runeseghers/OXYBLOOM/README.md

# Oxybloom
Een slimme bloem die huishoudens helpt om de luchtkwaliteit te verbeteren.

🛠️ Built by ``Dré Devaere`` & ``Rune Seghers``   
🔥 Supervised by ``prof. dr. Bas Baccarne``, ``Yannick Christiaens`` & ``Wouter Devriese``    
🌱 Grown at ``Ghent University`` 🏛️ ``Industrial Design Engineering`` ([project overview](https://github.com/basbaccarne/human-centered-design))       

13/06/2026  

## Samenvatting
Veel mensen ventileren hun huis niet op de juiste manier, of doen dit te weinig, vaak uit onwetendheid. Dit kan leiden tot een onnodig energieverbruik, slechtere luchtkwaliteit en vochtproblemen. Om inzicht te krijgen in dit probleem werd een enquête afgenomen bij ongeveer 100 respondenten. Daaruit bleek dat 50% van de deelnemers zich niet bewust is van het verband tussen duurzaamheid en correcte ventilatie. Dit wijst duidelijk op een kennis- en gedragskloof: veel mensen weten niet wanneer en hoe ze hun woning optimaal kunnen ventileren.

De oplossing is OXYBloom: een slimme bloem die gebruikers op een laagdrempelige en visueel aantrekkelijke manier begeleidt bij het ventileren op de juiste momenten en op de juiste manier. Het product meet voortdurend de luchtkwaliteit (CO₂ en vocht) en geeft hierover feedback via kleurveranderingen, een subtiele beweging van de bladeren en voice feedback. Via de bijhorende app krijgen gebruikers extra inzicht, bijvoorbeeld in hun energiebesparing, en kunnen ze het product personaliseren (kleuren, beloningssysteem). Een geïntegreerde luchtbevochtiger met waterreservoir zorgt bovendien voor een aangenamere luchtvochtigheid en versterkt de gebruikerservaring, doordat het bijvullen aanvoelt als het verzorgen van een echte plant.

Door dit hulpmiddel te gebruiken kunnen bewoners efficiënter ventileren, waardoor ze minder energie verbruiken om bijvoorbeeld te verwarmen. Daarnaast draagt correcte ventilatie bij aan een gezonder binnenklimaat: vochtproblemen en schimmelvorming worden beperkt, en de lucht in huis blijft frisser.

Op deze manier helpt onze oplossing niet alleen het energieverbruik te verminderen, maar verbetert het ook het wooncomfort en de gezondheid van de bewoners. Door bewust ventilatiegedrag te stimuleren op een manier die intuïtief, esthetisch en stand-alone werkt, sluiten we de kennis- en gedragskloof en zorgen we voor een duurzamere en gezondere leefomgeving.

<p align="center">
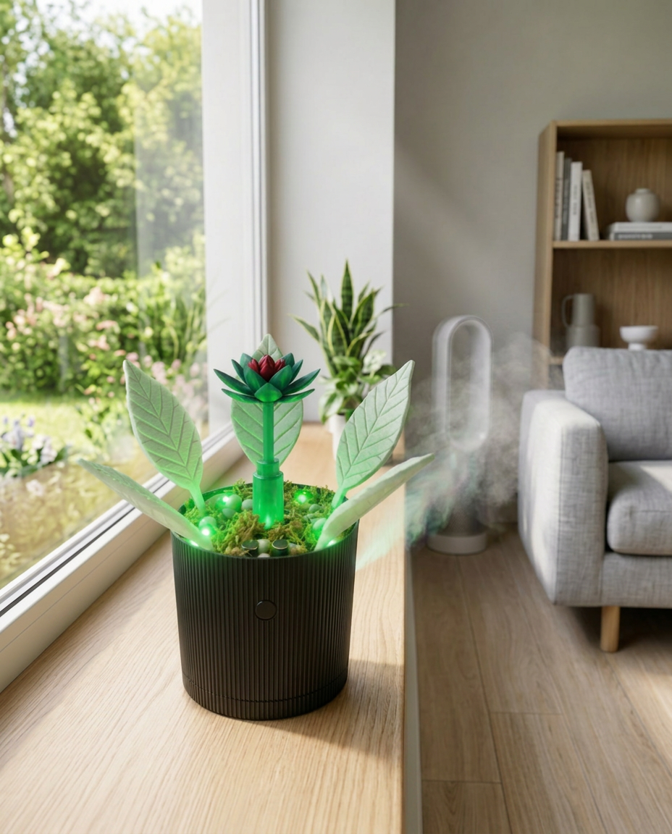
[picture p1: img/finale heroshot.png]
  
</p>

## Introductie
Veel mensen ventileren hun huis niet correct of doen dit te weinig, vaak uit onwetendheid. Dit kan leiden tot een slechtere luchtkwaliteit, vochtproblemen en onnodig energieverbruik, vooral in goed geïsoleerde woningen. Uit een [enquête](https://docs.google.com/document/d/1lkF2mxv8E-GvEGbEEImv3dyBfMGQf3W1utyAzGHfSRQ/edit?tab=t.0) onder ongeveer 100 respondenten bleek dat 50% van de deelnemers zich niet bewust is van het verband tussen duurzaamheid en correcte ventilatie. Dit laat zien dat er een duidelijke kennis- en gedragskloof bestaat: veel bewoners weten niet wanneer en hoe ze hun woning optimaal kunnen ventileren.

Het doel van dit project is een product te ontwerpen dat bewoners actief ondersteunt bij ventileren. Het apparaat meet continu het binnenklimaat, zoals luchtvochtigheid en CO₂-niveau. Op basis hiervan geeft het product signalen wanneer de luchtkwaliteit binnen niet goed is en het dus het beste moment is om te verluchten.

Doorheen het proces is dit basisconcept verder uitgewerkt tot Oxybloom: een bloemvormig product dat de status van de luchtkwaliteit communiceert via kleurveranderingen, een rustige, ademende beweging van de bladeren en voice feedback. Gebruikers bedienen het product via geïntegreerde knoppen op de pot zelf, en kunnen via een bijhorende [app](https://last-name-51594304.figma.site) dieper inzicht krijgen (zoals energiebesparing, een streak-systeem en het personaliseren van kleuren), zonder dat deze app verplicht is voor de basiswerking. Daarnaast werd een luchtbevochtiger met waterreservoir toegevoegd, die zowel de luchtvochtigheid verbetert als de interactie met het product aangenamer maakt. Ook de vorm, materialen en afwerking (CMF) van de bloem werden via meerdere gebruikerstests verfijnd, zodat het product esthetisch aansluit bij verschillende interieurs en als een natuurlijk, herkenbaar object in een woonruimte past.

Het product werkt energiebesparend en draagt bij aan een gezonder binnenklimaat. Door efficiënter te ventileren, hoeft minder energie te worden gebruikt om de woning te verwarmen of te koelen. Bovendien helpt het vochtproblemen en schimmelvorming te voorkomen, waardoor de luchtkwaliteit verbetert en de woning comfortabeler en gezonder wordt.

## Inhoudstafel

1. [Methodologie](./docs/methodologie.md)
2. [Discovery](./docs/discovery.md)
3. [Defintion](./docs/definition.md)
4. [Develop 1](./docs/develop_1.md)
5. [Develop 2](./docs/develop_2.md)
6. [Develop 3](./docs/develop_3.md)
7. [Design Requirements](./docs/design_requirements.md)
8. [Bill of materials](./docs/bom.md)
9. [Conclusie](./docs/conclusie.md)

## Kritische reflectie

Voor de eerste develop-fase hebben we, met behulp van een vernieuwd prototype, het project naar een hoger niveau kunnen tillen: gebruikers konden zich beter voorstellen hoe het product werkt, wat tot waardevolle inzichten leidde. Door tijdens de tests dieper door te vragen naar het "waarom" achter reacties, en door de Wizard of Oz-methode toe te passen, konden we observeren hoe voice feedback werd ontvangen en hierop bijsturen.

Achteraf bleek onze aanpak hier te weinig genuanceerd: we gingen uit van één type feedback voor alle situaties. Ook was het zo dat het beter zou zijn om te testen per parameter en niet enkele parameters in één keer.

Tijdens de tweede develop-fase hebben we een belangrijke les uit develop 1 in de praktijk gebracht: het belang van testen in de juiste context. Waar we in develop 1 onvoldoende rekening hielden met de omgeving waarin het product effectief gebruikt zou worden, hebben we dit in develop 2 wel meegenomen door de antropometrische tests en de gebruikerstests af te stemmen op realistische scenario's, zoals tafelhoogte en kasthoogte. Hierdoor verkregen we relevantere en bruikbaardere resultaten, die rechtstreeks bijdroegen aan de positionering van de knoppen en de algemene ergonomie van het product.

In de derde develop-fase lag de focus op het waterreservoir en de CMF-keuzes (Color, Material, Finish). Hoewel deze fase waardevolle inzichten heeft opgeleverd, merken we achteraf dat we hierbij iets te veel tijd hebben gespendeerd aan het verfijnen van het prototype, ten koste van de algemene voortgang. We willen voortdurend vooruitgang boeken in onze prototypes, maar moeten hierbij beter bewaken dat dit binnen een redelijke tijdspanne gebeurt, zodat de balans tussen kwaliteit en efficiëntie behouden blijft. Idealiter zouden de CMF-testen afgenomen worden bij personen wiens interieur aansluit bij de geteste bloempotstijl. Door de beperkte tijd was dit niet mogelijk, waardoor we testten bij personen met uiteenlopende interieurs. Dit maakte het moeilijker om een duidelijke lijn in de voorkeuren te vinden, maar leverde wel verschillende waardevolle perspectieven op.

## Noot inzake het gebruik van AI
AI werd gebruikt om inspiratie te verkrijgen over bestaande apparaten, zodat deze konden worden gebenchmarkt. Ook werd het gebruikt om een storyboard te maken na dat de verschillende situaties werden uitgeschreven. Het hero shot is ook deels gemaakt met AI. Verder werd AI ook gebruikt een interface te maken voor een toekomstige app via Figma Make om zo wat tijd te besparen.

Bij develop 3 is er gebruikt gemaakt van vizcom. Vizcom is een site waarop je foto's kan laten bewerken door AI. Dit werkt gebruikt om verschillende design keuzes te laten genereren door middel van kernwoorden.

Bij conclusie de kostprijscalculatie is gedaan aan de han van ai.

## Bijlagen
### Discovery
* Literatuuronderzoek (N=11)
  * [Rapport](https://docs.google.com/document/d/1AfcCo7FvvEoZ-1zk95RXVjzMou38a-mL8L6_zgns-Gg/edit?tab=t.0)
* Interviews (N=3)
  * [Protocol](https://docs.google.com/document/d/12qbczfWnEImfsNoVpZ4aLVHFY0JWGxJDZ43AeHY9-mw/edit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)
  * [Rapport](https://docs.google.com/document/d/1SwhVlLS8_lIYlqKu6CdZsSIWJLKw36k-8GklZlpGox8/edit?usp=sharing)
* Benchmarking (N=10)
  * [Rapport](https://docs.google.com/document/d/12xce8BJE52bgFbQwACKA-BeoK-U8daDStCAenrfK3ME/edit?tab=t.0).
* Enquête (N=104)
  * [Enquête](https://docs.google.com/forms/d/e/1FAIpQLSccWiVOp48grHZ2cQGmuoxTeAmDsEP0Rcj8K9Pg0Ig58J9OUA/viewform)
  * [Rapport](https://docs.google.com/document/d/1lkF2mxv8E-GvEGbEEImv3dyBfMGQf3W1utyAzGHfSRQ/edit?tab=t.0)

### Definition
* User testing wave 1 (N=13)
  * [Protocol](https://docs.google.com/document/d/1rY86oE0Vs1P8iOJ6PyYzX7_pxgFzCAlSUU5zqiSWN3I/edit?tab=t.0)
  * [Rapport](https://docs.google.com/document/d/1wBb8zgVL7p_F-QvWJVQwW2Svkrl49Ys-igBUbI4e8e8/edit?tab=t.0)
* User testing wave 2 (N=5)
  * [Protocol](https://docs.google.com/document/d/1o-T7NU_5Rs0rAPHm1JbzHmHQB5fDIzvxbv1kqwsdvhM/edit?usp=sharing)
  * [Rapport](https://docs.google.com/document/d/1fPvEVBDay3pfUAcs47p9CDcH445wIs4vGXjvJl6ddqQ/edit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)

### Develop 1
* User testing (N=5)
  *  [Protocol](https://docs.google.com/document/d/14uV6BEjJ6iHEM_Fh3N6zzjam72_YUCfdtqbi0Aa-V18/edit?tab=t.0)
  *  [Rapport](https://docs.google.com/document/d/18PjJ0K22VwaZccacPXWkhhGwo1DeL2UdXLAWv1GZMLM/edit?tab=t.0)

### Develop 2
* [Antropometrische Analyse](https://docs.google.com/document/d/1EPGG9i6jSZKGZ7VrqN3QsUSug69F0fZezZaDpOkvLG0/edit?tab=t.0)
* [Enquête Analyse](https://docs.google.com/document/d/19_CdSDRdH0FaFUVYFXiZnsAKY0Y2GnrCZgDpmhAUXtg/edit?tab=t.0)
* [User test protocool](https://docs.google.com/document/d/15RyFqs8qL6PJrg-n36wd5jC9kE5sktj_Zqppsj13D40/edit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)
* [User test analyse](https://docs.google.com/document/d/1LS81rWTh8fn5G55BaOMGvlZr1KS65SzYiV8W_BzbE0Y/edit?tab=t.0)
### Develop 3
* [User test protocool](https://docs.google.com/document/d/1AFxn7SNG4gidYgDGYXC2rl6uFhPbX5SC4VyNPNwO1w4/edit?tab=t.0)
* [User test analyse](https://docs.google.com/document/d/1FLf_whq74Fe5Exia7DLtALLMpERrBxRFpvECkAxbEaY/edit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)

## Licentie

This repository contains both software and design materials created as part of an industrial design energineering project at Ghent University.

- **Software and code:** [MIT License](./LICENSE-MIT)  
- **Design, documentation, CAD, and media:** [CC BY 4.0 License](./LICENSE)
  
You are free to reuse and build upon this work, both commercially and non-commercially, as long as proper attribution is given to the original authors.

## Bronnen
### Benchmarking:
Airthings. (2025). *Wave Plus radon & air quality monitor*. Geraadpleegd op 25 oktober 2025, van https://www.airthings.com/wave-plus
 
Awair. (2025). *Awair Glow air quality monitor*. Geraadpleegd op 25 oktober 2025, van https://www.getawair.com/glow
 
Blueair. (2025). *Blue Pure air purifier series*. Geraadpleegd op 25 oktober 2025, van https://www.blueair.com/nl
 
Eve Systems. (2025). *Eve Room indoor air quality monitor*. Geraadpleegd op 25 oktober 2025, van https://www.evehome.com/nl/eve-room
 
Foobot. (2025). *Foobot air quality monitor*. Geraadpleegd op 25 oktober 2025, van https://www.foobot.com
 
IKEA. (2025). *VINDSTYRKA air quality sensor*. Geraadpleegd op 25 oktober 2025, van https://www.ikea.com/nl/en/p/vindstyrka-air-quality-sensor-30515989/
 
Kaiterra. (2025). *Laser Egg air quality monitor*. Geraadpleegd op 25 oktober 2025, van https://www.kaiterra.com/laseregg
 
Netatmo. (2025). *Healthy Home Coach indoor air quality monitor*. Geraadpleegd op 25 oktober 2025, van https://www.netatmo.com/nl-nl/weather/healthcoach
 
Tado°. (2025). *Smart thermostat and room sensors*. Geraadpleegd op 25 oktober 2025, van https://www.tado.com/nl-nl
 
uHoo. (2025). *uHoo smart air monitor*. Geraadpleegd op 25 oktober 2025, van https://uhooair.com/nl/
