runeseghers/OXYBLOOM/cad/README.md

In deze folder zitten alle 3d modellen en assemblys die gebruikt zijn.

Assembly 1 is van het prototype develop 2.

Assembly 2 is van het prototype develop 3.
