runeseghers/OXYBLOOM/docs/methodologie.md

## Methodologie
<p align="left">
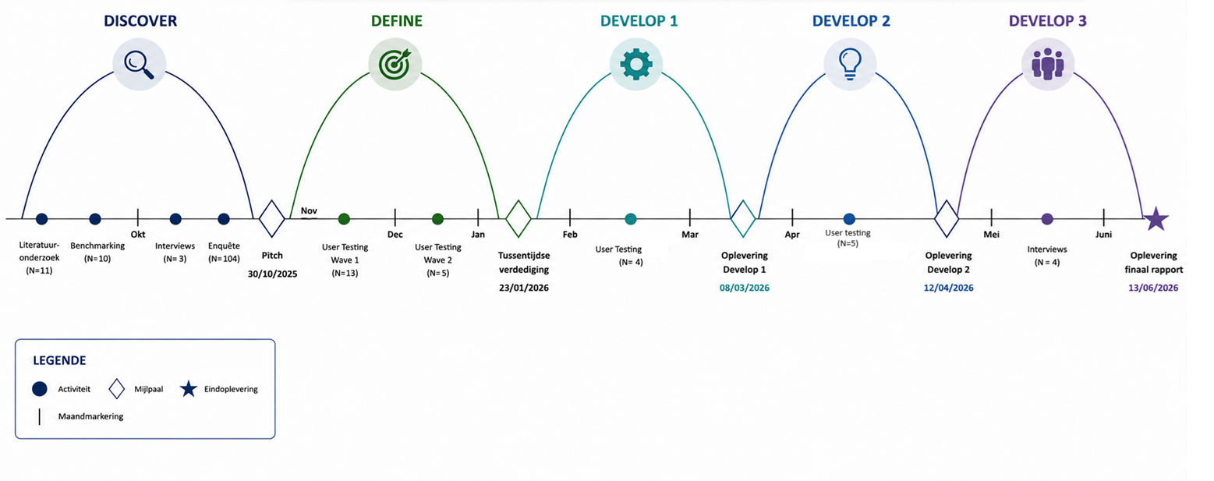
[picture p30: img/Finaal TD.png]
  
</p>
De methodologie volgt het triple diamond ontwerpmodel, bestaande uit vier fasen: discover, define, develop en deliver.

In de fase discover wordt via een litteratuuronderzoek (N=11) onderzoek gedaan naar bestaande kennis en inzichten over energie-armoede en de relatie met gedrag en keuzes. Het doel was het onderwerp beter te begrijpen, trends te identificeren, en mogelijke kansen of onderbelichte aspecten te ontdekken. Daarnaast werden er ook enkele interviews uitgevoerd (N=3). Terwijl deze interviews werden afgerond werd er ook een enquëte afgelegd (N=104), dit om een goed beeld te hebben van welke problemen zich waar bevinden en of er al maatregelen werden genomen. Als laatste werd er een benchmark analyse (N=10) gedaan, hier was het belangrijk om een inzicht te krijgen over welke producten er al bestaan en waar deze in uitblinken er waar er mogelijkheden zijn voor verbetering. Al deze inzichten werden gecombineerd om dan richting de define fase te gaan.

Tijdens de define-fase werden er twee waves afgelegd. Bij de eerste wave was het ons doel om aan de hand van 3 prototypes te onderzoeken welk van deze prototypes de mensen het beste aansprak en het meeste aanzette tot ingrijpen. Twee prototypes waren fysiek het derde was digitaal. De fysieke prototypes hadden een bloem en een parkiet als metafoor. Het digitaal illustreerde hoe het concept zou kunnen werken als het een volledig digitaal prototype was. Met deze prototypes werden enkele user interviews uitgevoerd (N=13). In de tweede wave werd er gepeild naar wat we nog konden toevoegen om de mensen nog meer aan te zetten. Er werd gepeild of een oplaadsysteem, een streaksysteem, een beloningsysteem en bewegende bladeren een positief effect zouden hebben. Dit werd aan de hand van verschillende digitale prototypes getest. Voor het testen werden enkele user interviews uitgevoerd (N=5).

In de eerste develop fase werd om de werking van het product en de interacties ervan te onderzoeken, verschillende methoden toegepast. We begonnen met storyboards om gebruiksscenario’s te visualiseren en interacties te identificeren. Vervolgens is een morfologische kaart opgesteld om functies en componenten systematisch te verkennen. Op basis hiervan zijn structuren uitgewerkt en een nieuw prototype gebouwd. De Wizard of Oz-methode werd gebruikt om voice feedback te testen bij gebruikers en inzicht te krijgen in voorkeuren voor bediening en visuele signalen.

In de tweede develop fase werd vooral de focus gelegd op de esthetische waarde van het product en de antropometrie. Er werd een antropometrische analyse uitgevoerd die ons verschillende inzichten gaven. Aan de hand van deze inzichten werd het prototype gemaakt die we gerbuikte in een user test (N=6). Deze test hield in waar de gerbuikers de knoppen zouden plaatsen en welke knoppen ze het liefst zouden willen. Ook werd een enquête gemaakt (N=29). Deze enquête ging over vooral de esthetische waarde van het product.

In de derde develop fase werd de focus gelegd op het waterreservoir en de CMF (Color, Material, Finish) van de verschillende onderdelen. Er werd een nieuw prototype gemaakt, voorzien van elektronica en code, zodat de functies (zoals de verlichting) effectief werkten en testpersonen een realistischer en duidelijker beeld kregen van het uiteindelijke product. Aan de hand van het Think Aloud Protocol werden user tests (N=4) uitgevoerd, waarbij testpersonen de handelingen voor het openen, vullen en sluiten van het waterreservoir uitvoerden en hierop reflecteerden. Daarnaast werd via Vizcom voor elk onderdeel (bladeren, steel, ventilatie, licht en bodemplaat) een reeks visuele mogelijkheden gegenereerd. Tijdens dezelfde testen werden de testpersonen gevraagd om per onderdeel hun drie meest favoriete en hun minst favoriete optie aan te duiden en te rangschikken, telkens met motivatie
