runeseghers/OXYBLOOM/docs/design_requirements.md

## Overzicht van Design Requirements
|| **Status** || ❌ niet voldaan || ⚠️ gedeeltelijk voldaan || ✅ voldaan || / niet meer van toepassing ||
|ID|Design Requirement Discovery|Source|Status|
|:---|:---|:---|:---:|
|**Algemeen**|
|1|Het product kan de luchtkwaliteit in een binnenruimte meten.|[Literatuuronderzoek](https://docs.google.com/document/d/1AfcCo7FvvEoZ-1zk95RXVjzMou38a-mL8L6_zgns-Gg/edit?tab=t.0)|✅|
|2|Het product kan onmiddellijk feedback geven wanneer de luchtkwaliteit verandert. |[Literatuuronderzoek](https://docs.google.com/document/d/1AfcCo7FvvEoZ-1zk95RXVjzMou38a-mL8L6_zgns-Gg/edit?tab=t.0)|✅|
|3|Het product heeft een kostprijs die geschikt is voor consumentenproducten voor thuisgebruik.|[Interviews](https://docs.google.com/document/d/1SwhVlLS8_lIYlqKu6CdZsSIWJLKw36k-8GklZlpGox8/edit?usp=sharing), [Enquête](https://docs.google.com/forms/d/e/1FAIpQLSccWiVOp48grHZ2cQGmuoxTeAmDsEP0Rcj8K9Pg0Ig58J9OUA/viewform), [Rapport](https://docs.google.com/document/d/12xce8BJE52bgFbQwACKA-BeoK-U8daDStCAenrfK3ME/edit?tab=t.0)|⚠️|
|4|De bloem is esthetisch aanvaardbaar om permanent zichtbaar te zijn in een woonruimte.|[Interviews](https://docs.google.com/document/d/1SwhVlLS8_lIYlqKu6CdZsSIWJLKw36k-8GklZlpGox8/edit?usp=sharing)|✅|
|5|Het product kan stand-alone functioneren.|[Interviews](https://docs.google.com/document/d/1SwhVlLS8_lIYlqKu6CdZsSIWJLKw36k-8GklZlpGox8/edit?usp=sharing)|✅|
|**Deelaspect**|
|1.1|Het product kan de luchtvochtigheid meten.|[Interviews](https://docs.google.com/document/d/1SwhVlLS8_lIYlqKu6CdZsSIWJLKw36k-8GklZlpGox8/edit?usp=sharing)|✅|
|1.2|Het product kan het CO₂-gehalte meten.|[Interviews](https://docs.google.com/document/d/1SwhVlLS8_lIYlqKu6CdZsSIWJLKw36k-8GklZlpGox8/edit?usp=sharing)|✅|
|1.3|Het product kan gas meten.|[Interviews](https://docs.google.com/document/d/1SwhVlLS8_lIYlqKu6CdZsSIWJLKw36k-8GklZlpGox8/edit?usp=sharing)|❌|
|2.1|Het product kan de gebruiker op afstand waarschuwen wanneer het tijd is om te verluchten.|[Interviews](https://docs.google.com/document/d/1SwhVlLS8_lIYlqKu6CdZsSIWJLKw36k-8GklZlpGox8/edit?usp=sharing)|❌|
|2.2|De bloem kan van kleur veranderen wanneer het tijd is om te verluchten.|[Interviews](https://docs.google.com/document/d/1SwhVlLS8_lIYlqKu6CdZsSIWJLKw36k-8GklZlpGox8/edit?usp=sharing)|✅|
|2.3|De bloem kan bewegen wanneer het tijd is om te verluchten.|[Interviews](https://docs.google.com/document/d/1SwhVlLS8_lIYlqKu6CdZsSIWJLKw36k-8GklZlpGox8/edit?usp=sharing)|✅|

|ID|Design Requirement Definition|Source|Status|
|:---|:---|:---|:---:|
|**Algemeen**|
|1|Het product kan een bloem gebruiken als metafoor om luchtkwaliteit te communiceren.|[Interviews](https://docs.google.com/document/d/1SwhVlLS8_lIYlqKu6CdZsSIWJLKw36k-8GklZlpGox8/edit?usp=sharing)|✅|
|2|Het product kan een beloningssysteem bevatten.|[Interviews](https://docs.google.com/document/d/1SwhVlLS8_lIYlqKu6CdZsSIWJLKw36k-8GklZlpGox8/edit?usp=sharing)|✅|
|3|Het product kan speels zijn zodat het aantrekkelijk is voor kinderen.|[Interviews](https://docs.google.com/document/d/1SwhVlLS8_lIYlqKu6CdZsSIWJLKw36k-8GklZlpGox8/edit?usp=sharing)|/|
|4|Het product kan functioneren op een interne energiebron.|[Interviews](https://docs.google.com/document/d/1SwhVlLS8_lIYlqKu6CdZsSIWJLKw36k-8GklZlpGox8/edit?usp=sharing)|⚠️|
|5|De gebruiker kan het product aan- en uitzetten en instellingen aanpassen.|[Interviews](https://docs.google.com/document/d/1SwhVlLS8_lIYlqKu6CdZsSIWJLKw36k-8GklZlpGox8/edit?usp=sharing)|✅|
|6|Het product kan zowel lokaal als op afstand worden bediend.|[Interviews](https://docs.google.com/document/d/1SwhVlLS8_lIYlqKu6CdZsSIWJLKw36k-8GklZlpGox8/edit?usp=sharing)|✅|
|7|Het product kan een geïntegreerd display bevatten.|[Interviews](https://docs.google.com/document/d/1SwhVlLS8_lIYlqKu6CdZsSIWJLKw36k-8GklZlpGox8/edit?usp=sharing)|/|
|8|Er kan een app beschikbaar zijn.|[Interviews](https://docs.google.com/document/d/1SwhVlLS8_lIYlqKu6CdZsSIWJLKw36k-8GklZlpGox8/edit?usp=sharing)|✅|
|9|De kleuren van het luchtkwaliteitsignaal kunnen aanpasbaar zijn.|[Interviews](https://docs.google.com/document/d/1SwhVlLS8_lIYlqKu6CdZsSIWJLKw36k-8GklZlpGox8/edit?usp=sharing)|✅|
|**Deelaspect**|
|2.1|Het product kan de voortgang van de gebruiker visualiseren via de groei van de stengel.|[Interviews](https://docs.google.com/document/d/1SwhVlLS8_lIYlqKu6CdZsSIWJLKw36k-8GklZlpGox8/edit?usp=sharing)|✅|
|2.2|Bloemetjes & kleuren vrijspelen: motivatie en personalisatie.|[Interviews](https://docs.google.com/document/d/1SwhVlLS8_lIYlqKu6CdZsSIWJLKw36k-8GklZlpGox8/edit?usp=sharing)|/|
|2.3|Wallet: inzicht in theoretische energie- of geldbesparing.|[Interviews](https://docs.google.com/document/d/1SwhVlLS8_lIYlqKu6CdZsSIWJLKw36k-8GklZlpGox8/edit?usp=sharing)|✅|
|3.1|De bloem maakt een rustige, continue beweging.|[Interviews](https://docs.google.com/document/d/1SwhVlLS8_lIYlqKu6CdZsSIWJLKw36k-8GklZlpGox8/edit?usp=sharing)|/|
|8.1|Op de app kunnen de beloningssystemen ter beschikking komen.|[Interviews](https://docs.google.com/document/d/1SwhVlLS8_lIYlqKu6CdZsSIWJLKw36k-8GklZlpGox8/edit?usp=sharing)|✅|

|ID|Design Requirement Develop 1|Source|Status|
|:---|:---|:---|:---:|
|**Algemeen**|
|1|Het product kan de status van de luchtkwaliteit communiceren via voice feedback.|[Analyse Test Develop 1](https://docs.google.com/document/d/18PjJ0K22VwaZccacPXWkhhGwo1DeL2UdXLAWv1GZMLM/edit?tab=t.0)|✅|
|2|Voice feedback is door de gebruiker handmatig te activeren.|[Analyse Test Develop 1](https://docs.google.com/document/d/18PjJ0K22VwaZccacPXWkhhGwo1DeL2UdXLAWv1GZMLM/edit?tab=t.0)|✅|
|3|Gedetailleerde informatie kan beschikbaar zijn via een applicatie.|[Analyse Test Develop 1](https://docs.google.com/document/d/18PjJ0K22VwaZccacPXWkhhGwo1DeL2UdXLAWv1GZMLM/edit?tab=t.0)|✅|
|4|Het product kan overal geplaatst worden in een woning.|[Analyse Test Develop 1](https://docs.google.com/document/d/18PjJ0K22VwaZccacPXWkhhGwo1DeL2UdXLAWv1GZMLM/edit?tab=t.0)|✅|
|5|Het product bevat een systeem met oplaadbare batterij|[Analyse Test Develop 1](https://docs.google.com/document/d/18PjJ0K22VwaZccacPXWkhhGwo1DeL2UdXLAWv1GZMLM/edit?tab=t.0)|✅|
|6|Het product kan primair de gezondheid van de woning tonen.|[Analyse Test Develop 1](https://docs.google.com/document/d/18PjJ0K22VwaZccacPXWkhhGwo1DeL2UdXLAWv1GZMLM/edit?tab=t.0)|✅|
|7|Het product kan energiebesparing presenteren als een bijkomend voordeel.|[Analyse Test Develop 1](https://docs.google.com/document/d/18PjJ0K22VwaZccacPXWkhhGwo1DeL2UdXLAWv1GZMLM/edit?tab=t.0)|✅|
|**Deelaspect**|
|1.1|De voice feedback kan kort, duidelijk en neutraal geformuleerd zijn.|[Analyse Test Develop 1](https://docs.google.com/document/d/18PjJ0K22VwaZccacPXWkhhGwo1DeL2UdXLAWv1GZMLM/edit?tab=t.0)|✅|
|1.2|De voice feedback kan voldoende informatie geven om een actie te kunnen uitvoeren.|[Analyse Test Develop 1](https://docs.google.com/document/d/18PjJ0K22VwaZccacPXWkhhGwo1DeL2UdXLAWv1GZMLM/edit?tab=t.0)|✅|
|5.1|Het product kan de gebruiker waarschuwen wanneer de batterij bijna leeg is.|[Analyse Test Develop 1](https://docs.google.com/document/d/18PjJ0K22VwaZccacPXWkhhGwo1DeL2UdXLAWv1GZMLM/edit?tab=t.0)|❌|

|ID|Design Requirement Develop 2|Source|Status|
|:---|:---|:---|:---:|
|**Algemeen**|
|1|Het product reguleert de luchtvochtigheid automatisch op basis van de omgevingsbehoefte.|[Analyse test develop 2](https://docs.google.com/document/d/1LS81rWTh8fn5G55BaOMGvlZr1KS65SzYiV8W_BzbE0Y/edit?tab=t.0)|⚠️|
|2|De audio- en helderheidsinstellingen zijn traploos en nauwkeurig aanpasbaar.|[Analyse test develop 2](https://docs.google.com/document/d/1LS81rWTh8fn5G55BaOMGvlZr1KS65SzYiV8W_BzbE0Y/edit?tab=t.0)|✅|
|3|De primaire productfuncties zijn onafhankelijk van de geopende of gesloten stand van de bloem toegankelijk.|[Analyse test develop 2](https://docs.google.com/document/d/1LS81rWTh8fn5G55BaOMGvlZr1KS65SzYiV8W_BzbE0Y/edit?tab=t.0)|✅|
|4|De bedieningselementen zijn visueel geïntegreerd in het ontwerp om de esthetiek van de pot te behouden.|[Analyse test develop 2](https://docs.google.com/document/d/1LS81rWTh8fn5G55BaOMGvlZr1KS65SzYiV8W_BzbE0Y/edit?tab=t.0)|✅|
|**Deelaspect**|
|1.1|Het bijvullen van het waterreservoir sluit aan bij de routine van het verzorgen van een reguliere plant.|[Analyse test develop 2](https://docs.google.com/document/d/1LS81rWTh8fn5G55BaOMGvlZr1KS65SzYiV8W_BzbE0Y/edit?tab=t.0)|✅|
|1.2|Het product geeft een visueel signaal wanneer het waterreservoir leeg is.|[Analyse test develop 2](https://docs.google.com/document/d/1LS81rWTh8fn5G55BaOMGvlZr1KS65SzYiV8W_BzbE0Y/edit?tab=t.0)|❌|

|ID|Design Requirement Develop 3|Source|Status|
|:---|:---|:---|:---:|
|**Algemeen**|
|1|Het ontwerp van het waterreservoir waarborgt een intuïtieve en ongehinderde gebruikersinteractie.|[Analyse test develop 3](https://docs.google.com/document/d/1FLf_whq74Fe5Exia7DLtALLMpERrBxRFpvECkAxbEaY/edit?tab=t.0)|✅|
|2|De CMF past perfect bij het interieur en het metafoor als bloem.|[Analyse test develop 3](https://docs.google.com/document/d/1FLf_whq74Fe5Exia7DLtALLMpERrBxRFpvECkAxbEaY/edit?tab=t.0)|✅|
|**Deelaspect**|
|1.1|De sluiting van het waterreservoir en de dop voorziet de gebruiker van duidelijke feedback.|[Analyse test develop 3](https://docs.google.com/document/d/1FLf_whq74Fe5Exia7DLtALLMpERrBxRFpvECkAxbEaY/edit?tab=t.0)|✅|
|1.2|De afmetingen van de dop zijn geoptimaliseerd voor universele fysieke toegankelijkheid.|[Analyse test develop 3](https://docs.google.com/document/d/1FLf_whq74Fe5Exia7DLtALLMpERrBxRFpvECkAxbEaY/edit?tab=t.0)|✅|
|1.3|Het waterreservoir is eenvoudig te reinigen.|[Analyse test develop 3](https://docs.google.com/document/d/1FLf_whq74Fe5Exia7DLtALLMpERrBxRFpvECkAxbEaY/edit?tab=t.0)|✅|
|2.1|De bladeren ondersteunen de natuurlijke esthetiek en textuur van het product.|[Analyse test develop 3](https://docs.google.com/document/d/1FLf_whq74Fe5Exia7DLtALLMpERrBxRFpvECkAxbEaY/edit?tab=t.0)|✅|
|2.2|De steel vormt de structurele en visuele verbinding in het ontwerp.|[Analyse test develop 3](https://docs.google.com/document/d/1FLf_whq74Fe5Exia7DLtALLMpERrBxRFpvECkAxbEaY/edit?tab=t.0)|✅|
|2.3|Het ventilatiesysteem is subtiel en onopvallend in het product verwerkt.|[Analyse test develop 3](https://docs.google.com/document/d/1FLf_whq74Fe5Exia7DLtALLMpERrBxRFpvECkAxbEaY/edit?tab=t.0)|✅|
|2.4|De verlichting versterkt de balans tussen technologie en natuur zonder te overheersen.|[Analyse test develop 3](https://docs.google.com/document/d/1FLf_whq74Fe5Exia7DLtALLMpERrBxRFpvECkAxbEaY/edit?tab=t.0)|✅|
|2.5|De bodemplaat zorgt voor een stabiele en natuurlijke landing van het product.|[Analyse test develop 3](https://docs.google.com/document/d/1FLf_whq74Fe5Exia7DLtALLMpERrBxRFpvECkAxbEaY/edit?tab=t.0)|✅|
