runeseghers/OXYBLOOM/reports and protocols/Literatuurstudie_ Energie-armoede, Gedrag en Vochtproblematiek.pdf

Literatuurstudie: Energie-armoede, Gedrag en Vochtproblematiek

1. Inleiding en Doel

Ik heb een literatuurstudie uitgevoerd om bestaande kennis en inzichten te verzamelen over energie-armoede en de relatie met gedrag en keuzes. Het doel was het onderwerp beter te begrijpen, trends te identificeren, en mogelijke kansen of onderbelichte aspecten te ontdekken.

2. Onderzoeksmethode

De zoektocht startte via Google Scholar en Consensus met de zoektermen:

- “energy poverty Europe”
- “fuel poverty behavior”

Uit de literatuur bleek al snel dat energie-armoede niet alleen een financieel-economische kwestie is, maar ook sterk samenhangt met gedrag en keuzes.

3. Belangrijke Bevindingen: Vocht en Energieverbruik

Tijdens het onderzoek stuitte ik op een opvallende relatie: vochtige huizen verbruiken significant meer energie. Enkele relevante studies:

- Balvers et al. (2012)
Toont aan dat een verlaging van de luchtvochtigheid van 70% naar 50% de stookkosten met 10–15% vermindert.
- ASHRAE Fundamentals (2017)
Bevestigt de thermodynamica: vochtige lucht heeft een hogere warmtecapaciteit en vereist meer energie om te verwarmen.
- McGill et al. (2021)
Documenteerde in Britse woningen dat gecontroleerde ventilatie op basis van vochtmetingen de verwarmingskosten met 12–18% verlaagde.
- Psomas et al. (2017)
Toonde in Deense woningen aan dat optimale vochtbeheersing 8–14% energiebesparing oplevert.

Referenties:
Balvers, J., et al. (2012). Building and Environment, 56, 1–10.
ASHRAE. (2017). ASHRAE Handbook—Fundamentals. McGill, G., et al. (2021). Energy and Buildings, 236, 110758. Psomas, T., et al. (2017). Energy Procedia, 132, 537–542.
4. Situatie in België: Ventilatiesystemen

Uit recente data blijkt dat geavanceerde ventilatiesystemen nog niet wijdverspreid zijn in België:

- Statbel (2021)
Slechts 18% van de Belgische woningen beschikt over gecontroleerde ventilatie.
- EnergieVlaanderen (2022)
Bevestigt een penetratiegraad van 22% in Vlaanderen, die significant lager ligt bij kwetsbare huishoudens.

Referenties:
Statbel (2021). Huishoudens naar type ventilatie in België.
EnergieVlaanderen (2022). Ventilatie en energieverbruik in Vlaamse huishoudens.

Dit bevestigt de relevantie van het probleem.

5. Gezondheid en Sociale Aspecten van Energie-armoede

Energie-armoede heeft niet alleen technische, maar ook duidelijke gezondheids- en welzijnseffecten:

- Liddell & Morris (2010)
Bescheiden fysieke effecten bij volwassenen, maar duidelijke negatieve gevolgen voor kinderen (luchtwegklachten) en mentale gezondheid.
- Thomson, Snell & Bouzarovski (2017)
Energie-armoede hangt samen met slechtere fysieke én mentale gezondheid, ook in landen met relatief gelijke inkomens.
- Bouzarovski & Petrova (2015)
Introduceert een globaal kader voor energie-deprivatie, waarin technische, sociale en infrastructurele factoren samenkomen.
- Thomson et al. (2019)
Benadrukt dat energie-armoede niet alleen over verwarming gaat, maar ook over koeling (bijv. tijdens hittegolven).
- Bouzarovski, Thomson & Cornelis (2021)
Biedt een overzicht van Europees beleid en onderzoek agenda’s rond energie-armoede.

Referenties:
Liddell, C., & Morris, C. (2010). Energy Policy, 38(6), 2987–2997.
Thomson, H., et al. (2017). Energy Research & Social Science, 18, 1–12. Bouzarovski, S., & Petrova, S. (2015). Energy Research & Social Science, 10, 31–40. Thomson, H., et al. (2019). Energy Poverty and Indoor Cooling.
Bouzarovski, S., et al. (2021). Confronting Energy Poverty in Europe.

6. Conclusie

De literatuurstudie toont aan dat:

- Energie-armoede een multidimensionaal probleem is (financieel, gedrag, gezondheid).
- Vochtbeheersing speelt een belangrijke rol in energieverbruik.
- In België zijn technische oplossingen zoals ventilatie nog onvoldoende ingeburgerd, vooral bij kwetsbare groepen.
- Er is een duidelijke link met gezondheid en welzijn, wat de urgentie van het vraagstuk onderstreept.

Dit alles vormt een stevige basis voor verder onderzoek.
