runeseghers/OXYBLOOM/reports and protocols/_Analyse enquête.pdf

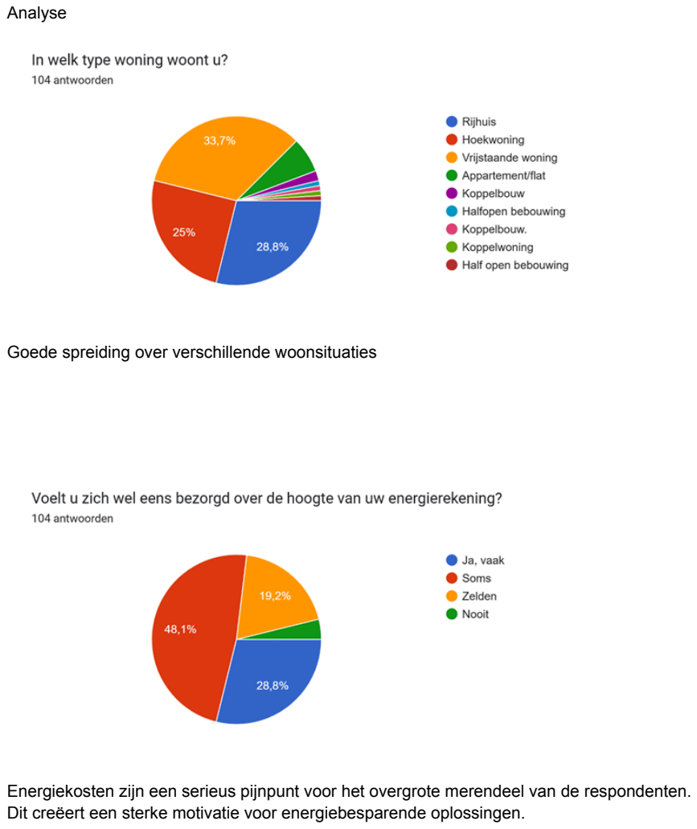
[picture p74: page 1]

Analyse

Goede spreiding over verschillende woonsituaties

Energiekosten zijn een serieus pijnpunt voor het overgrote merendeel van de respondenten. Dit creëert een sterke motivatie voor energiebesparende oplossingen.

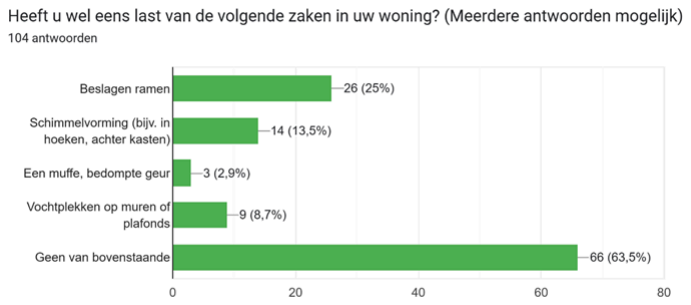
[picture p75: figure]

OPVALLEND:

- 36,5% van de respondenten heeft WÉL last van minstens één vochtprobleem
- Beslagen ramen is het meest voorkomende probleem (25%)
- Schimmel komt voor bij 13,5% - een serieus gezondheidsrisico
- De muffe geur wordt nauwelijks gerapporteerd (2,9%)

CONCLUSIE:
Hoewel de meerderheid (63,5%) geen ernstige vochtproblemen rapporteert, heeft een aanzienlijke minderheid van 36,5% wel degelijk problemen met vocht en ventilatie. Beslagen ramen zijn het meest voorkomende signaal van ventilatieproblemen.

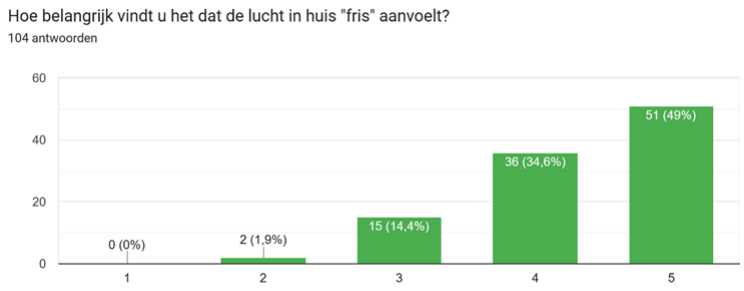
[picture p76: figure]

OPVALLEND:

- 83,6% van de respondenten vindt frisse lucht belangrijk tot zeer belangrijk (scores 4-5)
- Slechts 1,9% vindt het niet zo belangrijk (score 2)
- Niemand vindt het onbelangrijk (score 1)
- Sterke verschuiving naar de hoge kant van de schaal

CONCLUSIE:
Frisse lucht in huis wordt door het overgrote merendeel als zeer belangrijk ervaren. Dit creëert een sterke motivatie voor oplossingen die bijdragen aan een fris binnenklimaat.

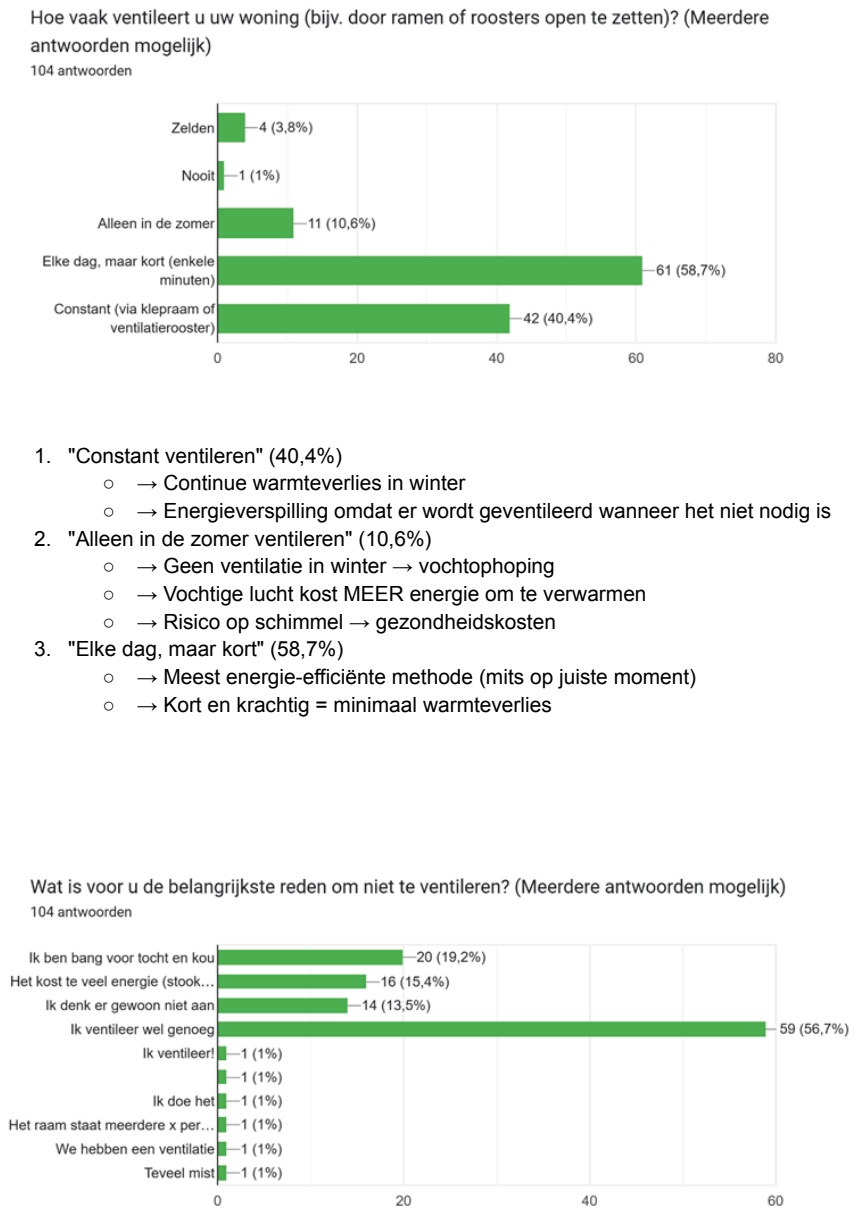
[picture p77: page 4]

1. "Constant ventileren" (40,4%)
- → Continue warmteverlies in winter
- → Energieverspilling omdat er wordt geventileerd wanneer het niet nodig is
2. "Alleen in de zomer ventileren" (10,6%)
- → Geen ventilatie in winter → vochtophoping
- → Vochtige lucht kost MEER energie om te verwarmen
- → Risico op schimmel → gezondheidskosten
3. "Elke dag, maar kort" (58,7%)
- → Meest energie-efficiënte methode (mits op juiste moment)
- → Kort en krachtig = minimaal warmteverlies

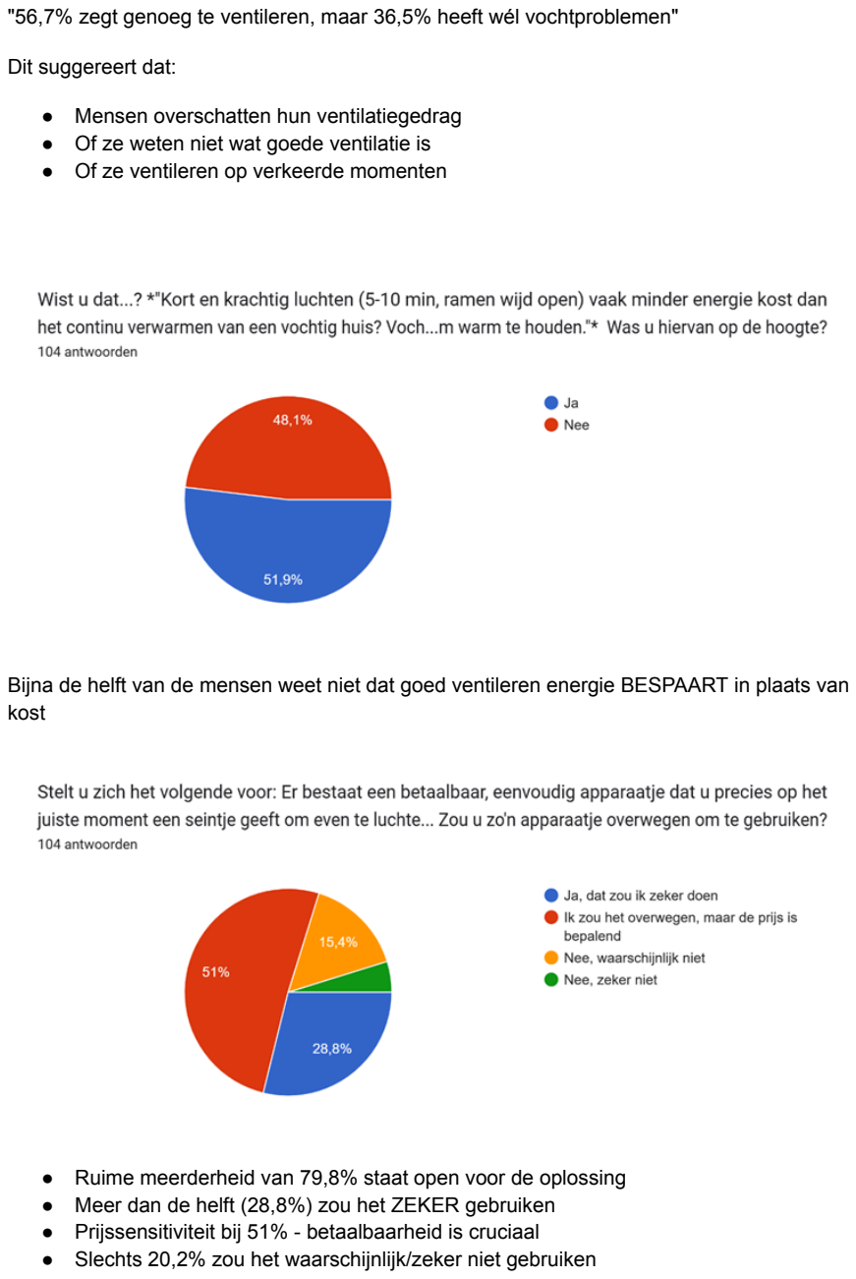
[picture p78: page 5]

"56,7% zegt genoeg te ventileren, maar 36,5% heeft wél vochtproblemen"

Dit suggereert dat:

- Mensen overschatten hun ventilatiegedrag
- Of ze weten niet wat goede ventilatie is
- Of ze ventileren op verkeerde momenten

Bijna de helft van de mensen weet niet dat goed ventileren energie BESPAART in plaats van kost

- Ruime meerderheid van 79,8% staat open voor de oplossing
- Meer dan de helft (28,8%) zou het ZEKER gebruiken
- Prijssensitiviteit bij 51% - betaalbaarheid is cruciaal
- Slechts 20,2% zou het waarschijnlijk/zeker niet gebruiken

“Ik heb deze enquête gelanceerd om een duidelijk beeld te krijgen van hoe mensen omgaan met ventilatie en energieverbruik in huis. De resultaten zijn veelzeggend: 76,9% van de deelnemers maakt zich zorgen over de hoogte van de energierekening. Toch blijkt dat bijna de helft – 48,1% – niet wist dat kort en krachtig luchten energiezuiniger is dan constant ventileren of helemaal niet luchten.

Uit een andere grafiek blijkt dat 36,5% van de respondenten kampt met vochtproblemen, zoals schimmel of beslagen ramen. Dit bevestigt dat er een duidelijke kloof is tussen kennis en gedrag. Maar er is ook goed nieuws: maar liefst 80% staat open voor een eenvoudige tool die aangeeft wanneer het ideale moment is om te luchten.

Met deze inzichten kunnen we een slimme, toegankelijke oplossing ontwikkelen die niet alleen het binnenklimaat verbetert, maar ook zorgt voor een lagere energierekening.”
