runeseghers/OXYBLOOM/img/Energie.jpg

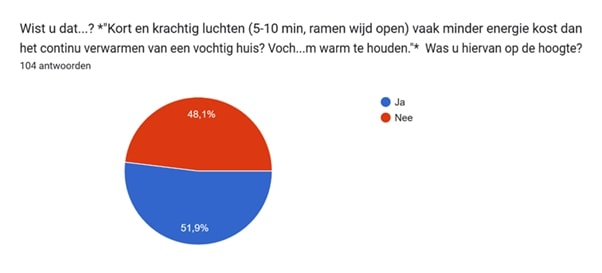
img/Energie.jpg
