runeseghers/OXYBLOOM/img/Finaal heroshot.png

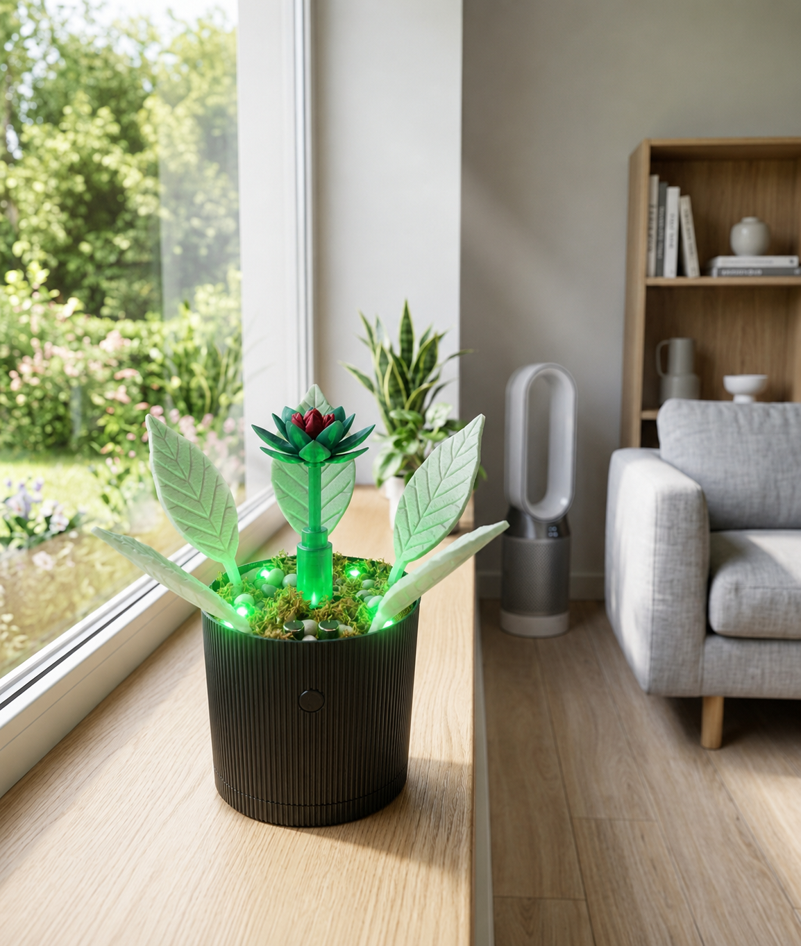
img/Finaal heroshot.png
