runeseghers/OXYBLOOM/img/heroshot_bloem.png

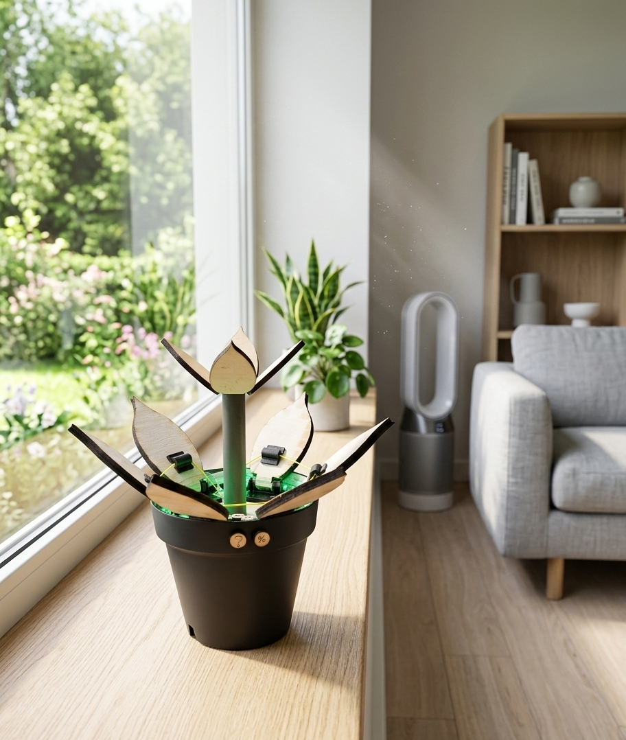
img/heroshot_bloem.png
