runeseghers/OXYBLOOM/img/HTA.png

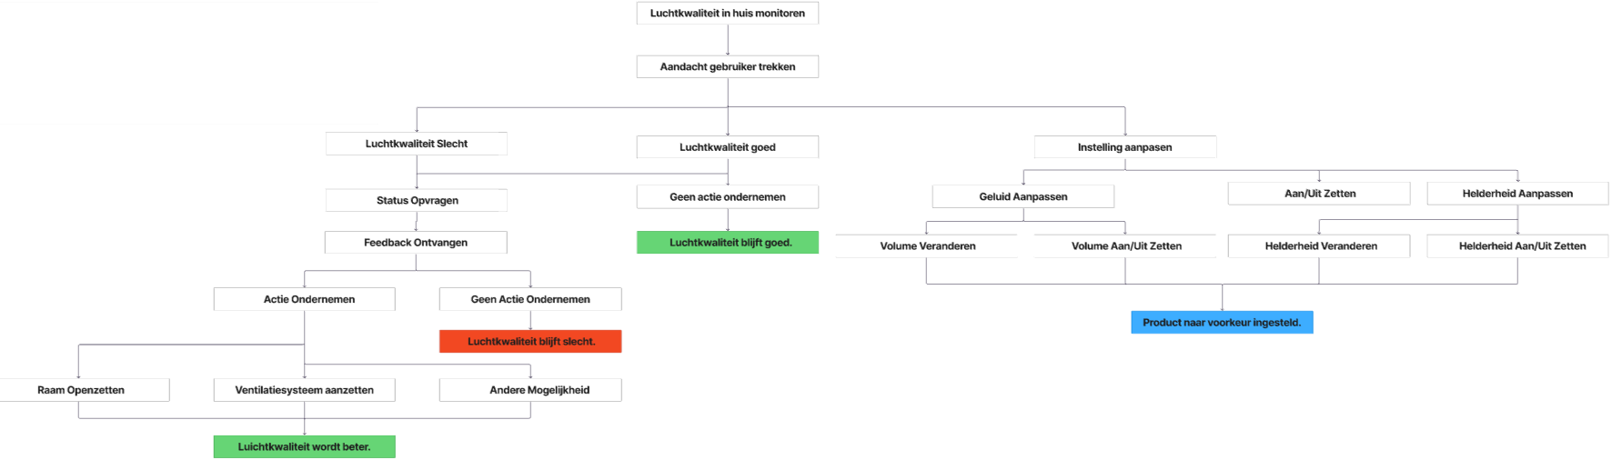
img/HTA.png
