runeseghers/OXYBLOOM/img/IMG_1425.jpg

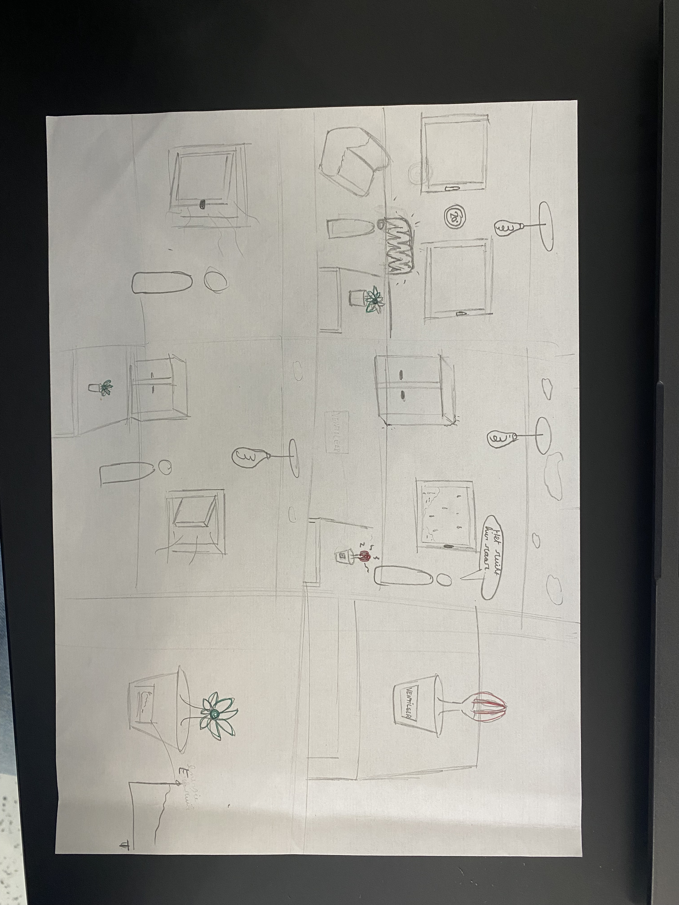
img/IMG_1425.jpg
