runeseghers/OXYBLOOM/img/Kopen.jpg

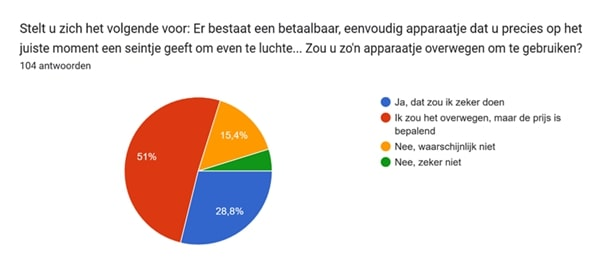
img/Kopen.jpg
