runeseghers/OXYBLOOM/img/OXYBLOOM (4).jpg

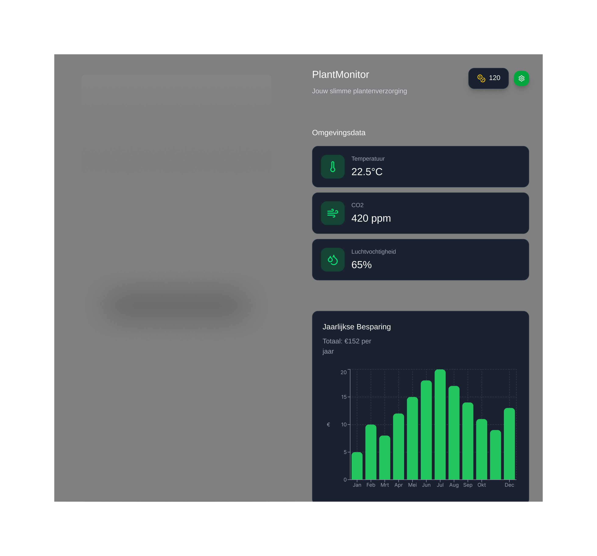
img/OXYBLOOM (4).jpg
