runeseghers/OXYBLOOM/img/Problemen.jpg

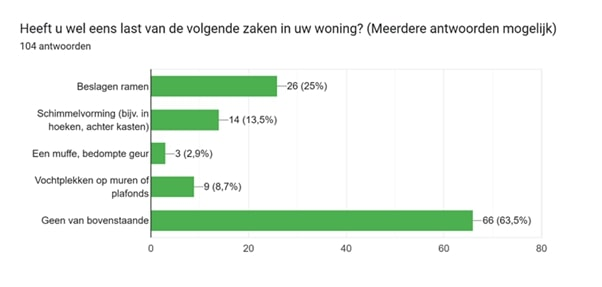
img/Problemen.jpg
