runeseghers/OXYBLOOM/img/Prototypes.png

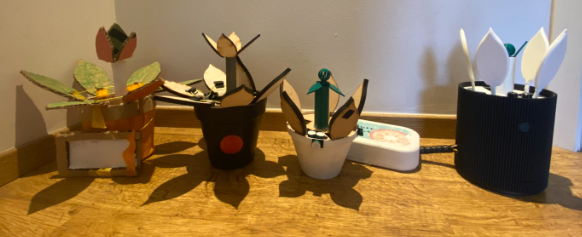
img/Prototypes.png
