runeseghers/OXYBLOOM/img/render bloem jpeg.jpg

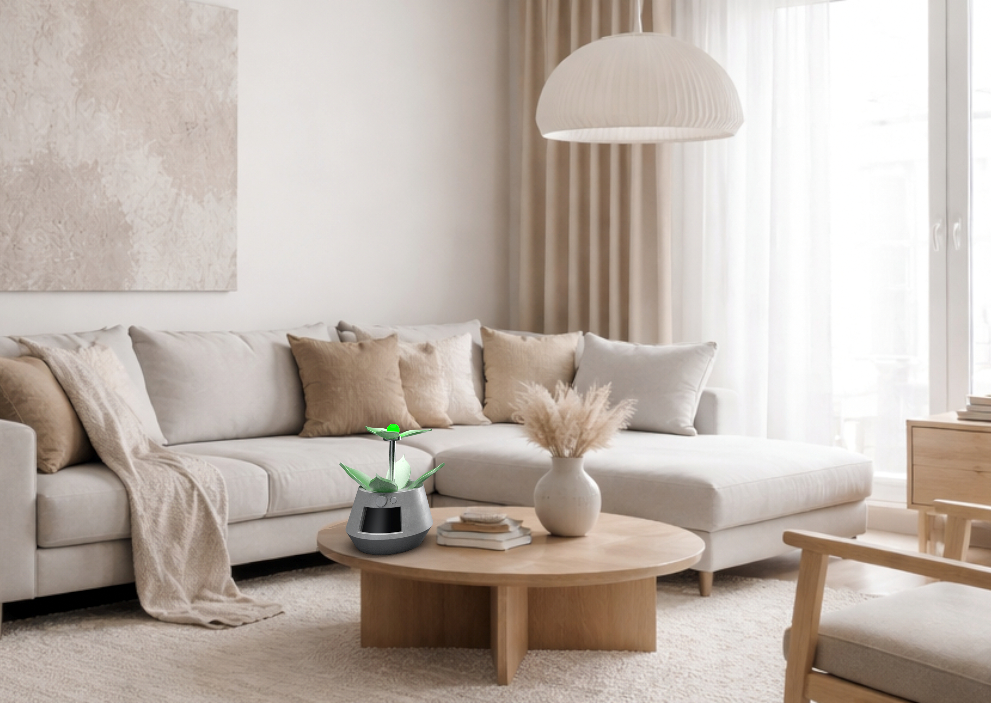
img/render bloem jpeg.jpg
