runeseghers/OXYBLOOM/img/Schermafbeelding 2026-04-12 202738.png

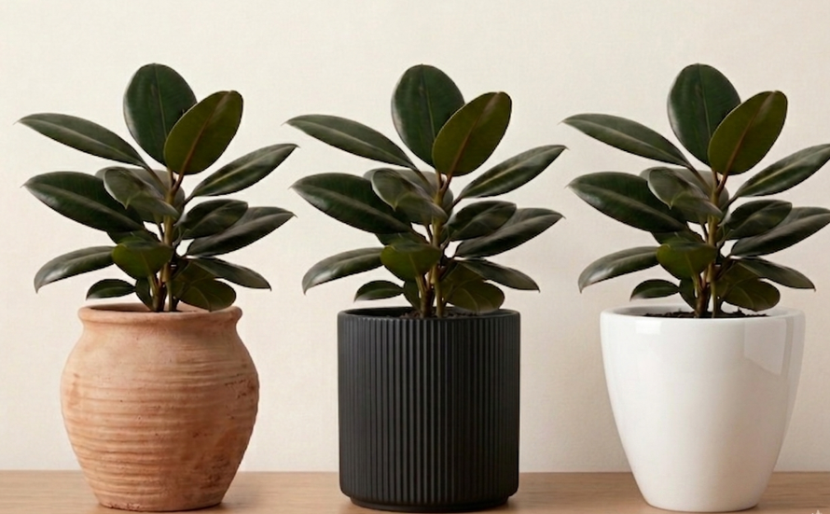
img/Schermafbeelding 2026-04-12 202738.png
