runeseghers/OXYBLOOM/img/Schermafbeelding 2026-05-28 163634.png

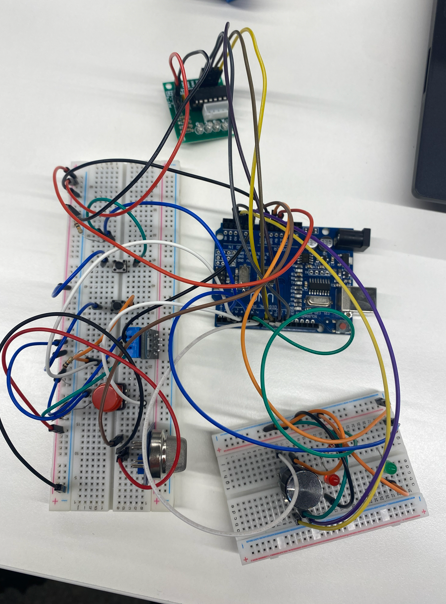
img/Schermafbeelding 2026-05-28 163634.png
