runeseghers/OXYBLOOM/img/Triple Diamond (2).png

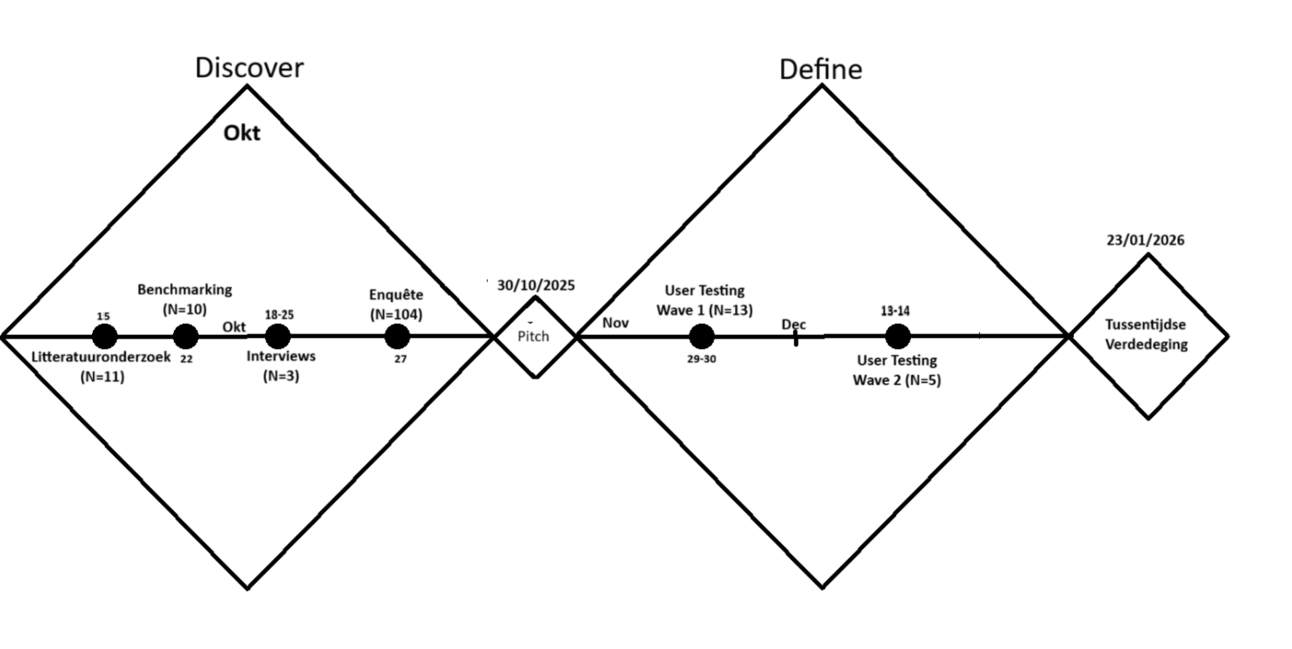
img/Triple Diamond (2).png
