runeseghers/OXYBLOOM/img/Triple Diamond Develop1.png

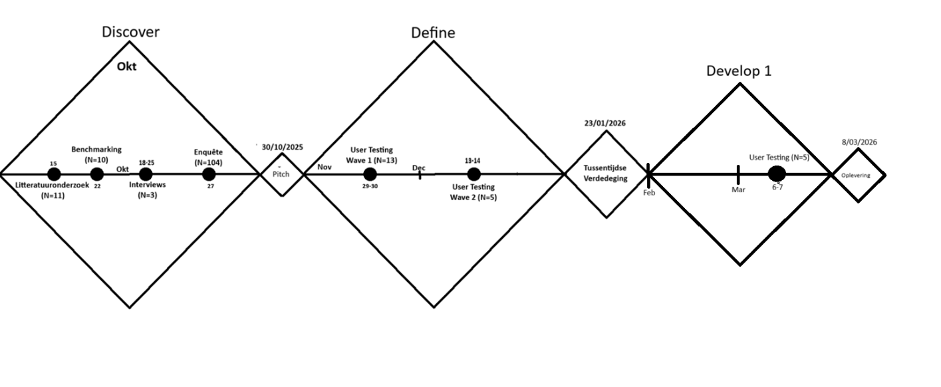
img/Triple Diamond Develop1.png
