runeseghers/OXYBLOOM/img/Triple Diamond Develop2.png

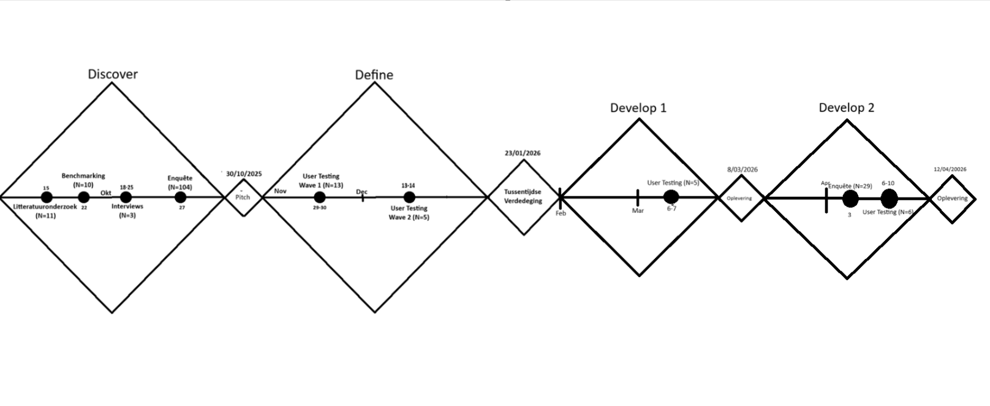
img/Triple Diamond Develop2.png
