runeseghers/OXYBLOOM/docs/bom.md

# Bill Of Materials
### Software
- Arduino.ino
### Microcontroller
- Arduino Mega 2560
### Libraries
- Stepper library
- DHT library
- DFRobotDFPlayerMini library
- Adafruit Unified Sensor library
### Sensoren
- DHT11 (vocht/temperatuursensor)
- MQ-135 (CO2-sensor)
### Componenten
- 2x Stappenmotor 4 fasen 5 V
- 2x ULN2003 (stappenmotor driver)
- 2x RGB Led
- 4x Weerstand 220 Ohm
- 3x Weerstand 1k Ohm
- 2x Drukknop
- 2x Potentiometer
- DFR 0299 (DFplayer)
- Micro SD kaart
- Speaker 8 Ohm
- Kabels
- Batterij 9V
- 9V Batterij clip naar 2.1mm DC plug
- Mini breadbord
- Half breadbord
## 3D-print
Alle mechanische componenten zijn ge 3D print. De files zijn te vinden in (...). Alle onderdelen werden in PLA geprint. 
## Verbindingselementen
Om de stappen motoren en luidspreker vast te maken aan de 3d print is gebruik gemaakt van: 
* 6 M3 imbusbouten
* 6 M3 zeskantmoeren
* 6 M3 sluitringen
## Connectieschema
<p align="left">
  
</p>
