runeseghers/OXYBLOOM/(list of files, cad)

Other CAD files:
cad/assembly 2/2de stam.prt
cad/assembly 2/As blad.prt
cad/assembly 2/Dichting dekseln watertank.prt
cad/assembly 2/Drukknop mechanisme.prt
cad/assembly 2/Knop_houder.prt
cad/assembly 2/Magneethouder.prt
cad/assembly 2/Watertank.prt
cad/assembly 2/as groot tandwiel.prt
cad/assembly 2/as_tandwiel_2.prt
cad/assembly 2/assemblypot1.prt
cad/assembly 2/blad 5.0.prt
cad/assembly 2/blad houder 3.0.prt
cad/assembly 2/deksel.prt
cad/assembly 2/drukknop 2.prt
cad/assembly 2/drukknop test.prt
cad/assembly 2/drukknop.prt
cad/assembly 2/gaten bladen.prt
cad/assembly 2/gear motor 2.prt
cad/assembly 2/gear motor.prt
cad/assembly 2/kleinblad.prt
cad/assembly 2/kleine as.prt
cad/assembly 2/motor.prt
cad/assembly 2/nieuw plateau.prt
cad/assembly 2/nieuwe schroef.prt
cad/assembly 2/pot 1 cilinder.prt
cad/assembly 2/schuine knop houder.prt
cad/assembly 2/spezker.prt
cad/assembly 2/staande stam 2.0.prt
cad/assembly 2/stam met blad.prt
cad/assembly 2/tandwiel_2.prt
cad/assembly_1/assembly bloem.prt
cad/assembly_1/blad.prt
cad/assembly_1/klein blad.prt
cad/assembly_1/lichtbal.prt
cad/assembly_1/pot.prt
cad/assembly_1/scherm.prt
cad/assembly_1/steel.prt
