runeseghers/OXYBLOOM/reports and protocols/Analyse Test Develop 1.pdf

Test persoon 1

Is de info die je nu weet voldoende om een actie uit te voeren en om alles te weten over je huis/luchtkwaliteit.

1. Waarom 2 knoppen en niet gewoon 1 knop en geen exacte.

Alle info in de app; knoppen van de helderheid en aan en uit en geluid via app dus op de bloem 1 knop.

2. Een scherm is niet nodig het is lelijker, een app en knop is genoeg
3. Neutraal is makkelijker, het is kort en simpel.
4. Ik verkies zonnepanelen en oplaadbaar, omdat zonnepanelen ervoor zorgen dat je geen elektriciteit betaalt en als er geen zonlicht genoeg is kan je het opladen. Het zal misschien wat duurder zijn maar ik vind dat de moeite waard want stroom kost ook geld
5. Gezondheid van mijn huis is belangrijker dan besparen. De gezondheid van je huis is de gezondheid van jezelf. Ik wist niet dat je zo geld kon besparen.

extra

Zou je niets kunnen doen met water?

Kinderen kunnen meer geactiveerd worden door lichtjes en alarm signaaltjes die leuk zijn.

Ik zou het voorzien van licht die flitst en melding doet voor hardhorende mensen. Het zou leuk zijn om het bloemetje water te geven en dat het daardoor werkt. Het kunnen instellen van het flikkeren is leuk. Melding accu plat gaan.

Test persoon 2

1. Ik weet alles wat ik moet weten.
2. Voice is beter dan een scherm want met een bril is het soms moeilijk te lezen.
3. Het kortste vond ik het beste.
4. Ik zou een stekker kiezen voor het gemak insteken en klaar, ja er gaat daar nu wel een kabel liggen maar dat vind ik niet erg.
5. Je gezondheid is wel belangrijker he.

Test persoon 3

1. Ik kan vol vertrouwen een beslissing nemen want ik weet genoeg. De knop is gemakkelijker dan op de app te kijken.
2. Een scherm zou niet per se meer info geven en als de pot in de zon staat kan je het niet lezen .
3. Het eerste is korter en to the point het andere is wat ‘bepampert’.
4. Usb en zonnepanelen ; je moet er niet veel voor kijken en als het donkere dagen zijn kan je het altijd opladen. Functionaliteit prioriteer ik. Als het veel duurder is dan gewoon oplaadbaar.
5. Ja, gezondheid is het belangrijkste.

extra

Iets met water geven zou wel leuk zijn .

Test persoon 4

Er wordt eerst op het vraagteken gedrukt

1. Ja, ik moet het huis verluchten. Als ik ook de exacte info in 1 drukknop wist dan zou dat beter zijn maar het is niet nodig om een actie uit te voeren.
2. Een scherm zou niet echt meer info kunnen geven. Ook is een knop gemakkelijker dan een app openen.
3. Het eerste is duidelijker en to the point.
4. Met een oplaadbare batterij en zonnepanelen kan je ze dan zetten waar je wilt. Dat zo een batterij extra kost vind ik niet erg, ik zou extra betalen zodat het altijd werkt en dat je hem kan zetten waar je wilt, als mensen dan kopen en de batterij gaat leeg dan gaan mensen het niet meer opladen en dan staat dat daar.
5. In functie van gezondheid is alles goed. Ik verkies gezondheid boven geld besparen.

Test persoon 5

1. De voice feedback werd eerst niet begrepen, extra uitleg was nodig
2. Een scherm zou misschien wel wat gemakkelijker zijn, maar je kan ook gewoon nog eens klikken op de knop om het nog eens te horen.
3. Het was duidelijk achteraf en de beknopte voice feedback is beter

4. Met een kabel met stekker zou die in de weg kunnen liggen. Ik zou eerder een oplaadbare batterij kiezen dan wegwerpbatterijen omdat dat beter is voor het milieu. De extra kosten vind ik niet erg als ik het kan terug winnen na een tijdje.
5. Gezondheid gaat boven alles en boven geld dus ja

Bevindingen tijdens testen: ouderen vonden het moeilijker om de voice feedback te begrijpen.

Conclusies

1. Voice feedback is een bruikbare manier om informatie te geven

Uit de tests blijkt dat voice feedback een geschikte methode is om de status van de woning te communiceren. De meeste testpersonen gaven aan dat ze voldoende informatie kregen om een actie te ondernemen, zoals het verluchten van het huis.

Bij vier van de vijf testpersonen was de informatie duidelijk genoeg om een beslissing te nemen. Slechts één testpersoon had in het begin extra uitleg nodig om de feedback correct te begrijpen.

De boodschap moet kort, duidelijk en eenvoudig blijven.

2. Korte en neutrale voice feedback wordt het best ontvangen

Alle testpersonen gaven aan dat ze de korte en neutrale vorm van voice feedback verkiezen.

De langere en meer persoonlijke manier van communiceren werd minder positief ervaren omdat deze:

- minder efficiënt aanvoelt
- soms als “bepamperend” werd ervaren

Dit toont aan dat gebruikers vooral snelle en duidelijke informatie willen.

3. Een scherm op het product is niet noodzakelijk

De meerderheid van de testpersonen gaf aan dat een scherm op het product niet nodig is.

Belangrijkste redenen:

- een scherm kan esthetisch storend zijn
- een scherm kan moeilijk leesbaar zijn in zonlicht
- gebruikers verkiezen voice feedback gecombineerd met een app
4. Het aantal knoppen op het product kan verminderd worden

Tijdens de test werd opgemerkt dat twee knoppen op het product verwarrend kunnen zijn.

Meerdere testpersonen gaven aan dat:

- één knop voldoende is om informatie op te vragen
- extra informatie beter in de app kan worden weergegeven

Een eenvoudigere interface verhoogt dus de gebruiksvriendelijkheid.

5. Gebruikers verkiezen een flexibele stroomvoorziening

De voorkeur voor stroomvoorziening verschilde tussen gebruikers, maar er zijn duidelijke trends.

Veel testpersonen gaven de voorkeur aan:

- een oplaadbare batterij
- eventueel in combinatie met zonnepanelen

Redenen hiervoor zijn:

- het product kan overal geplaatst worden
- het werkt deels zelfstandig
- het is energiezuinig

Andere gebruikers verkiezen een stekker, omdat dit het meest betrouwbaar en eenvoudig is.

Hieruit kan geconcludeerd worden dat gebruiksgemak en flexibiliteit belangrijker zijn dan de laagste kostprijs. En omdat je zonnepanelen niet overal in huis even goed werken wordt de flexibiliteit weer minder dus zal gekozen worden voor een oplaadbare batterij.

6. De ontwerpvisie van het product klopt

Alle testpersonen gaven aan dat de gezondheid van de woning belangrijker is dan financiële besparingen.

Gebruikers zien het product dus voornamelijk als een:

gezondheidsmonitor voor de woning

Energiebesparing wordt gezien als een bijkomend voordeel, maar niet als de hoofdreden om het product te gebruiken.

7. Extra observaties uit de test

Tijdens de tests kwamen nog enkele interessante suggesties naar voren:

- interactieve elementen zoals lichtsignalen of flikkeringen kunnen extra aandacht trekken
- meldingen bij een lege batterij zijn belangrijk
- sommige gebruikers vinden het leuk als het product speelse interacties heeft, zoals water geven aan de bloem

Nieuwe Design Requirements

- Het product moet de status van het huis kunnen communiceren via voice feedback
- De voice feedback moet kort, duidelijk en neutraal geformuleerd zijn.
- De voice feedback moet voldoende informatie geven om een actie te kunnen uitvoeren.
- Het product moet een knop bevatten waarmee de gebruiker voice feedback kan activeren.
- Gedetailleerde informatie moet beschikbaar zijn via een applicatie.
- De applicatie moet gebruikers toelaten om instellingen aan te passen zoals:
- helderheid van het licht
- volume van voice feedback
- aan/uit status
- Het product kan flexibel geplaatst worden in een woning.
- Het product bevat een systeem met oplaadbare batterij
- Het product kan de gebruiker waarschuwen wanneer de batterij bijna leeg is.
- Het primaire doel van het product moet het tonen van de gezondheid van de woning zijn.
- Energiebesparing moet worden gepresenteerd als een bijkomend voordeel.
