runeseghers/OXYBLOOM/reports and protocols/Interviewprotocol – Test Develop 1.pdf

# Protocol Test Develop 1

### 1. Doel van de test

Het doel van deze test is om te onderzoeken of voice feedback een geschikte manier is om de status van een woning weer te geven. Daarnaast willen we nagaan op welke manier deze feedback het best wordt aangeboden.

Verder willen we bepalen of voice feedback op zichzelf voldoende is, of dat het beter werkt als aanvulling op een visuele interface, zoals een scherm.

We willen ook nagaan welk type voice feedback beter wordt ontvangen: een neutrale stem of een meer persoonlijke en menselijke manier van communiceren.

Daarnaast testen we of de extra kosten van een batterij en zonnepanelen de moeite waard zijn, door verschillende concepten van hoe we het product kunnen voorzien van stroom aan de gebruikers voor te stellen.

Tot slot vragen we de gebruikers of onze huidige ontwerpvisie klopt: namelijk dat het primaire doel van het product het tonen van de gezondheid van het huis is, waarbij energiebesparing een bijkomend voordeel is. We onderzoeken ook of gebruikers eerder vinden dat financiële besparing het belangrijkste doel van het product moet zijn.

### 2. Introductie

Wij werken momenteel aan een concept dat de status van je huis kan tonen, bijvoorbeeld op vlak van gezondheid en energieverbruik. Het doel is om bewoners op een eenvoudige en toegankelijke manier bewust te maken van de gezondheid van hun woning.

Vandaag testen we een prototype van een interactieve bloem. Deze bloem geeft feedback via voice feedback, kleuren en beweging

### 3. Introductie van het prototype

In de bloem zit een speaker die voice feedback geeft, alsof dit een definitief onderdeel van het product zou zijn. Dit prototype wordt voornamelijk gebruikt om de voice feedback te testen.

### 1. Testmoment – Voice Feedback (Wizard of Oz)

Scenario:

Stel dat je thuis bent en de bloem verandert van kleur of beweegt. Je wilt weten wat de status van je huis is.

Er zijn 2 knoppen waarop je kan drukken, 1 is voor de status en acties en de ander voor exacte info over waarden van de luchtkwaliteit.

De feedback zal gegeven worden door een speaker(Wizard of Oz)

### 2. Interviewvragen na de test

2.1 Is de info die je nu weet voldoende om een actie uit te voeren en om alles te weten over je huis/luchtkwaliteit. Wat mis je eventueel nog om vol vertrouwen een beslissing te nemen?

2.2 Zou een scherm meer info geven? en zo ja waarom (app is sowieso aanwezig met interface)

2.3 Hoe ervaarde je de manier van communiceren? Vond je de stem prettig neutraal, of zou je liever een persoonlijkere, menselijke toon horen?

We geven verschillende oplossingen voor producten om te kunnen bepalen welke voeding het beste is.

2.4 Stel je voor: dit product staat in je woonkamer. Welke voor- en nadelen zie je bij de volgende manieren van stroomvoorziening?

- Kabel met stekker
- AA batterijen die je moet vervangen
- Oplaadbare batterij die je af en toe moet opladen
- Zelfvoorzienend: bevat batterij, zonnepaneel
- Zonnepanelen + oplaadbaar

(Een zonnepaneel of dure accu maakt het product duurder in aanschaf, maar makkelijker in gebruik. Is die extra investering volgens jou de moeite waard voor dit specifieke apparaat?)

2.5. We hebben nu gefocust op het tonen van de gezondheid/status van je huis/luchtkwaliteit, waarbij energiebesparing een bijkomend voordeel is. Denkt u dat we in de juiste richting bezig zijn.

### 6. Afsluiting

Bedankt voor je deelname.
Jouw feedback helpt ons om het concept verder te verbeteren.

a
