runeseghers/OXYBLOOM/(commit log)

2025-12-17 Update bom.md
    Bom
2026-04-03 speed motor verandert
2026-04-09 Nieuwe code met vochtigheids sensor
2026-04-12 Nieuwe code met led erbij
2026-04-12 co2 sensor erbij
2026-04-12 motor werkt nu op vocht en ppm
2026-04-12 led fout verbetert
2026-04-12 tests voor de dfplayer
2026-04-12 led fout verbeterd
2026-04-12 led regelbaar met potentio meter
2026-05-07 de setup en einde erbij
2026-05-07 motoren omgedraaid
2026-05-07 oiverbodige leds eruit gehaald
2026-05-07 eerste test voor de outputs
2026-05-07 motor trager laten gaan
2026-05-07 2 de voice feeback toegevoegd
2026-05-07 motoren anders laten draaien
2026-06-09 verandering code snelheid motor
2026-06-12 mappen aanmaken
    [assembly bloem.prt, blad.prt, klein blad.prt, lichtbal.prt, pot.prt, scherm.prt, steel.prt]
2026-06-13 cad files ass 2 toegevoegd
    [2de stam.prt, As blad.prt, Dichting dekseln watertank.prt, Drukknop mechanisme.prt, Knop_houder.prt, Magneethouder.prt, Watertank.prt, as groot tandwiel.prt]
